Arkaqius/SmartSwitch/_00_ECAD&MCAD/_00_ECAD/SmartSwitch2.png

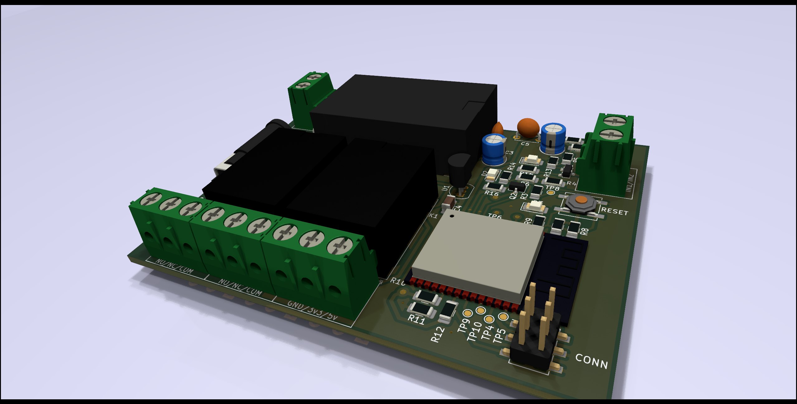
_00_ECAD&MCAD/_00_ECAD/SmartSwitch2.png
