Arkaqius/SmartSwitch/_00_ECAD&MCAD/_00_ECAD/SmartSwitch.png

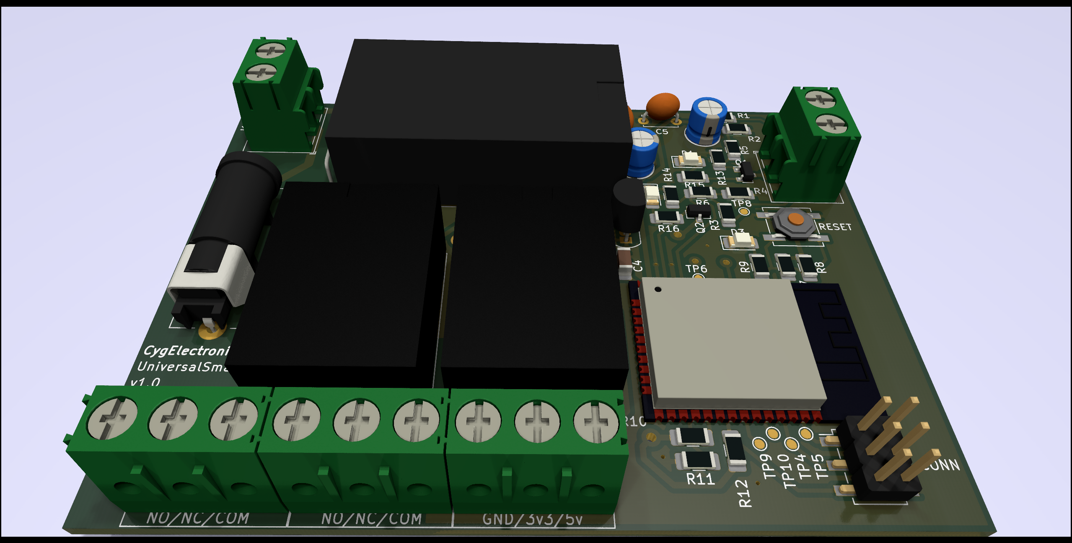
_00_ECAD&MCAD/_00_ECAD/SmartSwitch.png
