Arkaqius/SmartSwitch/_00_ECAD&MCAD/_01_MCAD/smart_switch.FCStd

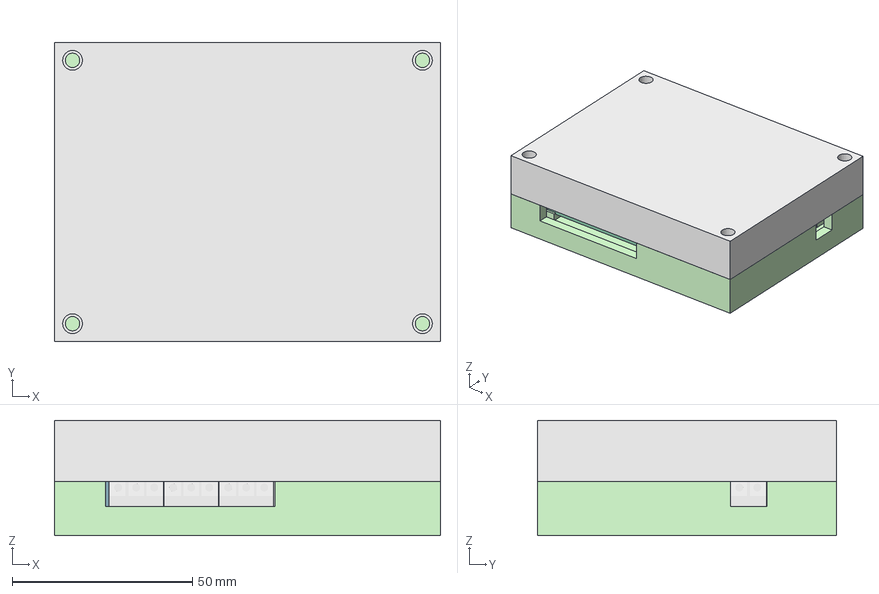
[picture p3: CAD file, 2022-10-03]
_00_ECAD&MCAD/_01_MCAD/smart_switch.FCStd
107.0 x 83.0 x 32.0 mm
Pcb_1aa9
U2_ESP32-WROOM-32_00006151aafd
R22_R_1206_3216Metric_00006151ab81
R16_R_1206_3216Metric_00006151abb1
R21_R_1206_3216Metric_00006151ac20
R13_R_1206_3216Metric_00006151ac80
R15_R_1206_3216Metric_00006151acb0
R11_R_1206_3216Metric_00006151ad40
R10_R_1206_3216Metric_00006151ada0
R14_R_1206_3216Metric_00006151add0
R12_R_1206_3216Metric_00006151ae00
R9_R_1206_3216Metric_00006151ae30
C6_CP_Radial_D50mm_P250mm_00006151aed3
Q1_SOT_23_00006151afed
R7_R_1206_3216Metric_00006151b061
R6_R_1206_3216Metric_00006151b0dc
R5_R_1206_3216Metric_00006151b10c
D5_LED_1206_3216Metric_00006151b13e
D3_LED_1206_3216Metric_00006151b174
C4_C_1206_3216Metric_00006151b1a8
R3_R_1206_3216Metric_00006151b1d8
R4_R_1206_3216Metric_00006151b22c
C5_C_Disc_D50mm_W25mm_P500mm_00006151b260
IN1/IN2_TerminalBlock_Phoenix_PT_15_2_50_H_1x02_P500mm_Horizontal_00006151b2b3
D4_LED_1206_3216Metric_00006151b31b
Q2_SOT_23_00006151b353
R8_R_1206_3216Metric_00006151b38b
NO/NC/COM 1_TerminalBlock_Phoenix_PT_15_3_50_H_1x03_P500mm_Horizontal_00006151b49c
C2_C_Disc_D50mm_W25mm_P500mm_00006151b52d
C3_CP_Radial_D50mm_P250mm_00006151b5ed
Var1_C_Disc_D60mm_W25mm_P500mm_00006151b705
NO/NC/COM 2_TerminalBlock_Phoenix_PT_15_3_50_H_1x03_P500mm_Horizontal_00006151b787
GND/3v3/5v_TerminalBlock_Phoenix_PT_15_3_50_H_1x03_P500mm_Horizontal_00006151b823
F2_R_Axial_DIN0204_L36mm_D16mm_P508mm_Vertical_00006151b899
D2_LED_1206_3216Metric_00006151bbb8
D7_D_DO-41_SOD81_P10.16mm_Horizontal_00006151b9d8
CONN_PinHeader_2x03_P254mm_Vertical_SMD_00006151ba44
U1_TO-92_Inline_Narrow_00006151bab5
R2_R_1206_3216Metric_00006151bb23
J1_TerminalBlock_Phoenix_PT_15_2_50_H_1x02_P500mm_Horizontal_00006151bc61
D1_LED_1206_3216Metric_00006151b996
D6_D_DO-41_SOD81_P10.16mm_Horizontal_00006151bbfa
RESET_SW_SPST_TL3342_000061ec6e21
Relay1
Relay2
HiLink
fuse
U3_SOT_223_00006151abe6
R19_R_1206_3216Metric_00006151ac50
R18_R_1206_3216Metric_00006151ace0
R17_R_1206_3216Metric_00006151ad10
R20_R_1206_3216Metric_00006151ad70
Q3_SOT_23_00006151b029
Q4_SOT_23_00006151b95c
R1_R_1206_3216Metric_00006151b8c5
bottom_final
bottom_final (Meshed)
top (Meshed)
