Arkaqius/SmartSwitch/_00_ECAD&MCAD/_00_ECAD/SmartSwitch.kicad_pcb

## KiCad design _00_ECAD&MCAD/_00_ECAD/SmartSwitch.kicad_pcb (2022-10-04)

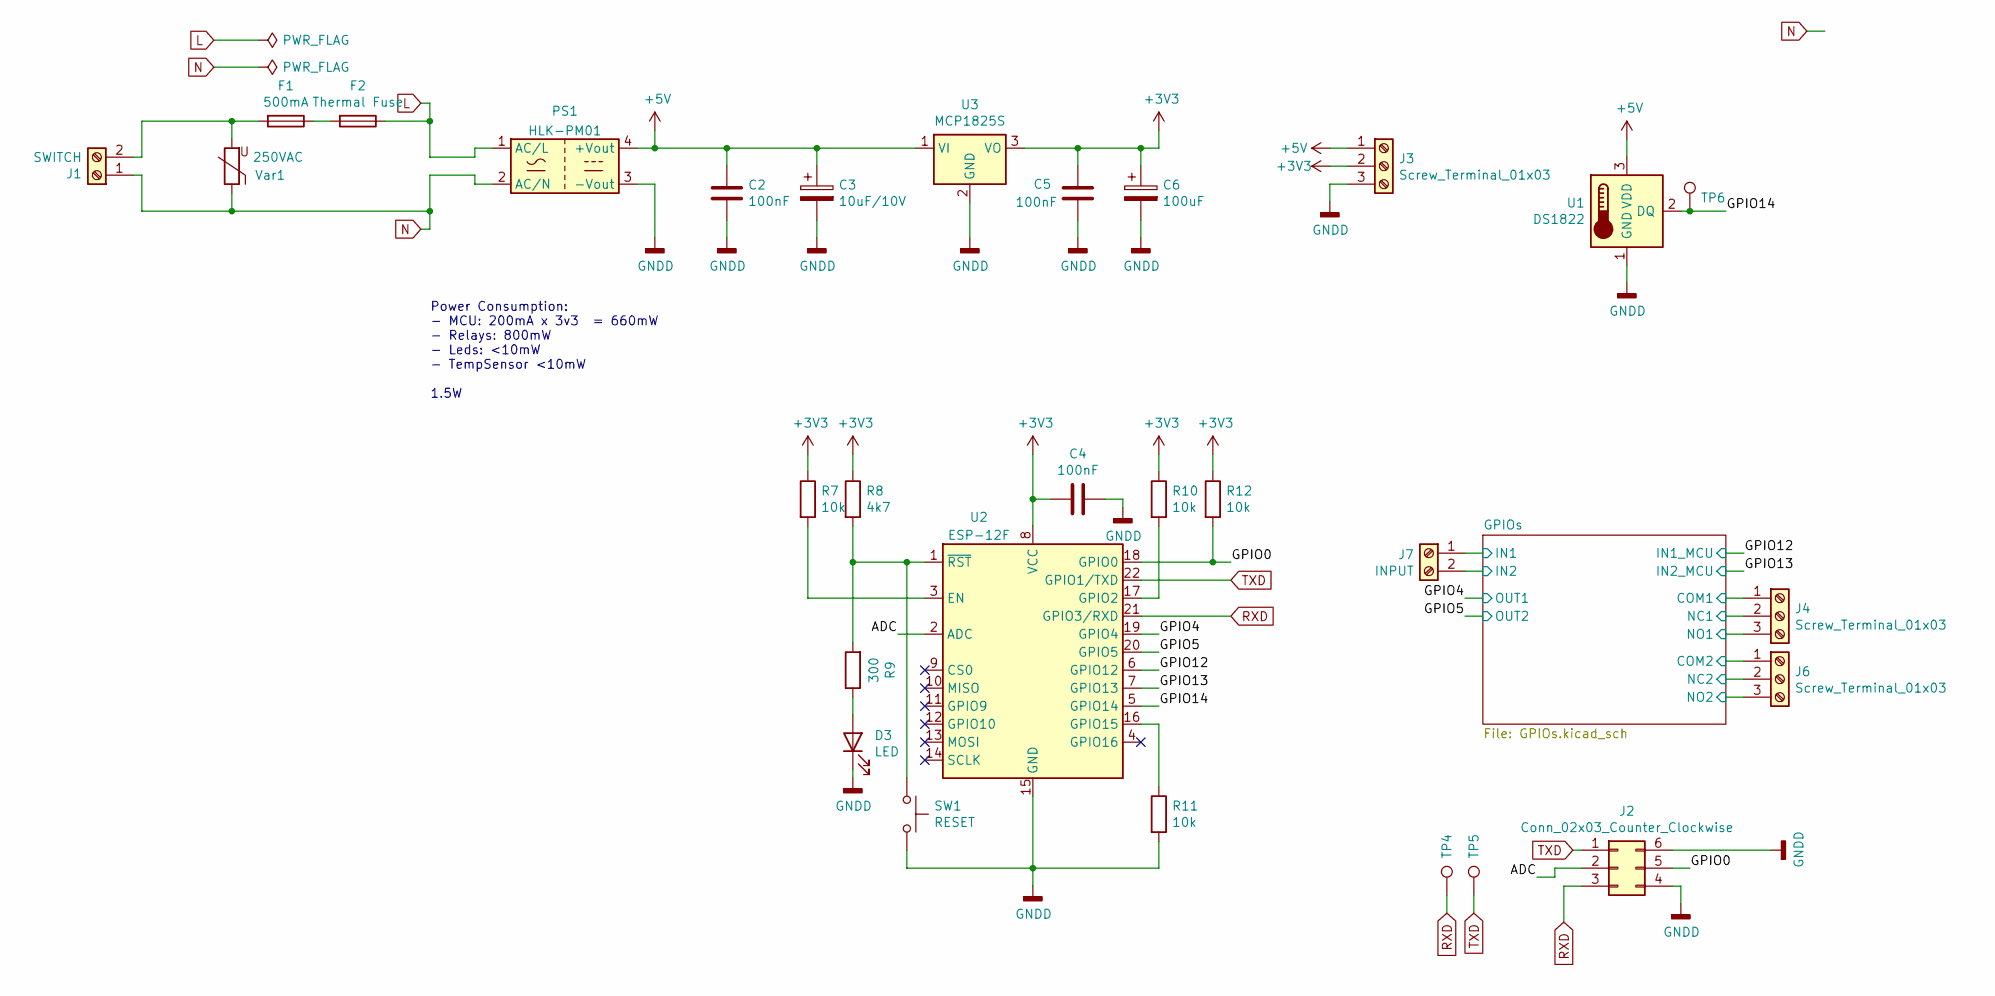
[picture p4: schematic SmartSwitch.kicad_sch]

Parts:
C2, C5: 100nF; C_Disc_D5.0mm_W2.5mm_P5.00mm
C3: 10uF/10V; CP_Radial_D5.0mm_P2.50mm
C4: 100nF; C_1206_3216Metric_Pad1.42x1.75mm_HandSolder
C6: 100uF; CP_Radial_D5.0mm_P2.50mm
D3: LED; LED_1206_3216Metric_Pad1.42x1.75mm_HandSolder
F1: 500mA; Fuseholder_Cylinder-5x20mm_Schurter_0031_8201_Horizontal_Op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
F2: Thermal Fuse; R_Axial_DIN0204_L3.6mm_D1.6mm_P5.08mm_Vertical
J1: SWITCH; TerminalBlock_Phoenix_MKDS-1,5-2_1x02_P5.00mm_Horizontal
J2: Conn_02x03_Counter_Clockwise; PinHeader_2x03_P2.54mm_Vertical_SMD
J3, J4, J6: Screw_Terminal_01x03; TerminalBlock_Phoenix_MKDS-1,5-3_1x03_P5.00mm_Horizontal
J7: INPUT; TerminalBlock_Phoenix_MKDS-1,5-2_1x02_P5.00mm_Horizontal
PS1: HLK-PM01; Converter_ACDC_HiLink_HLK-PMxx
R7, R10, R11, R12: 10k; R_1206_3216Metric_Pad1.42x1.75mm_HandSolder
R8: 4k7; R_1206_3216Metric_Pad1.42x1.75mm_HandSolder
R9: 300; R_1206_3216Metric_Pad1.42x1.75mm_HandSolder
SW1: RESET; SW_SPST_B3SL-1022P
TP4, TP5, TP6: TestPoint; TestPoint_Pad_D1.0mm
U1: DS1822; TO-92_Inline
U2: ESP-12F; ESP-12E
U3: MCP1825S; SOT-223
Var1: 250VAC; RV_Disc_D7mm_W3.4mm_P5mm

Connections:
+3V3: C4.2, C5.1, C6.1, J3.2, R7.1, R8.1, R10.1, R12.1, U2.8 (VCC), U3.3 (VO); also elsewhere on the board
+5V: C2.1, C3.1, J3.1, PS1.4 (+Vout), U1.3 (VDD), U3.1 (VI); also elsewhere on the board
/ADC: J2.2, U2.2 (ADC)
/GPIO0: J2.5, R12.2, U2.18 (GPIO0)
/GPIO4: U2.19 (GPIO4); also elsewhere on the board
/GPIO5: U2.20 (GPIO5); also elsewhere on the board
/GPIO12: U2.6 (GPIO12); also elsewhere on the board
/GPIO13: U2.7 (GPIO13); also elsewhere on the board
/GPIO14: TP6.1, U1.2 (DQ), U2.5 (GPIO14)
/GPIOs/COM1: J4.1; also elsewhere on the board
/GPIOs/COM2: J6.1; also elsewhere on the board
/GPIOs/IN1: J7.1; also elsewhere on the board
/GPIOs/IN2: J7.2; also elsewhere on the board
/GPIOs/NC1: J4.2; also elsewhere on the board
/GPIOs/NC2: J6.2; also elsewhere on the board
/GPIOs/NO1: J4.3; also elsewhere on the board
/GPIOs/NO2: J6.3; also elsewhere on the board
GNDD: C2.2, C3.2, C4.1, C5.2, C6.2, D3.1 (K), J2.4, J2.6, J3.3, PS1.3 (-Vout), R11.2, SW1.2, U1.1 (GND), U2.15 (GND), U3.2 (GND); also elsewhere on the board
L: F2.1, PS1.1 (AC/L)
N: J1.1, PS1.2 (AC/N), Var1.1
unnamed: D3.2 (A), R9.1
unnamed: F1.1, F2.2
unnamed: F1.2, J1.2, Var1.2
unnamed: R7.2, U2.3 (EN)
unnamed: R8.2, R9.2, SW1.1, U2.1 (~RST)
unnamed: R10.2, U2.17 (GPIO2)
unnamed: R11.1, U2.16 (GPIO15)
RXD: J2.3, TP4.1, U2.21 (GPIO3/RXD)
TXD: J2.1, TP5.1, U2.22 (GPIO1/TXD)

Notes on the sheet:
Power Consumption: - MCU: 200mA x 3v3 = 660mW - Relays: 800mW - Leds: <10mW - TempSensor <10mW ~{} 1.5W

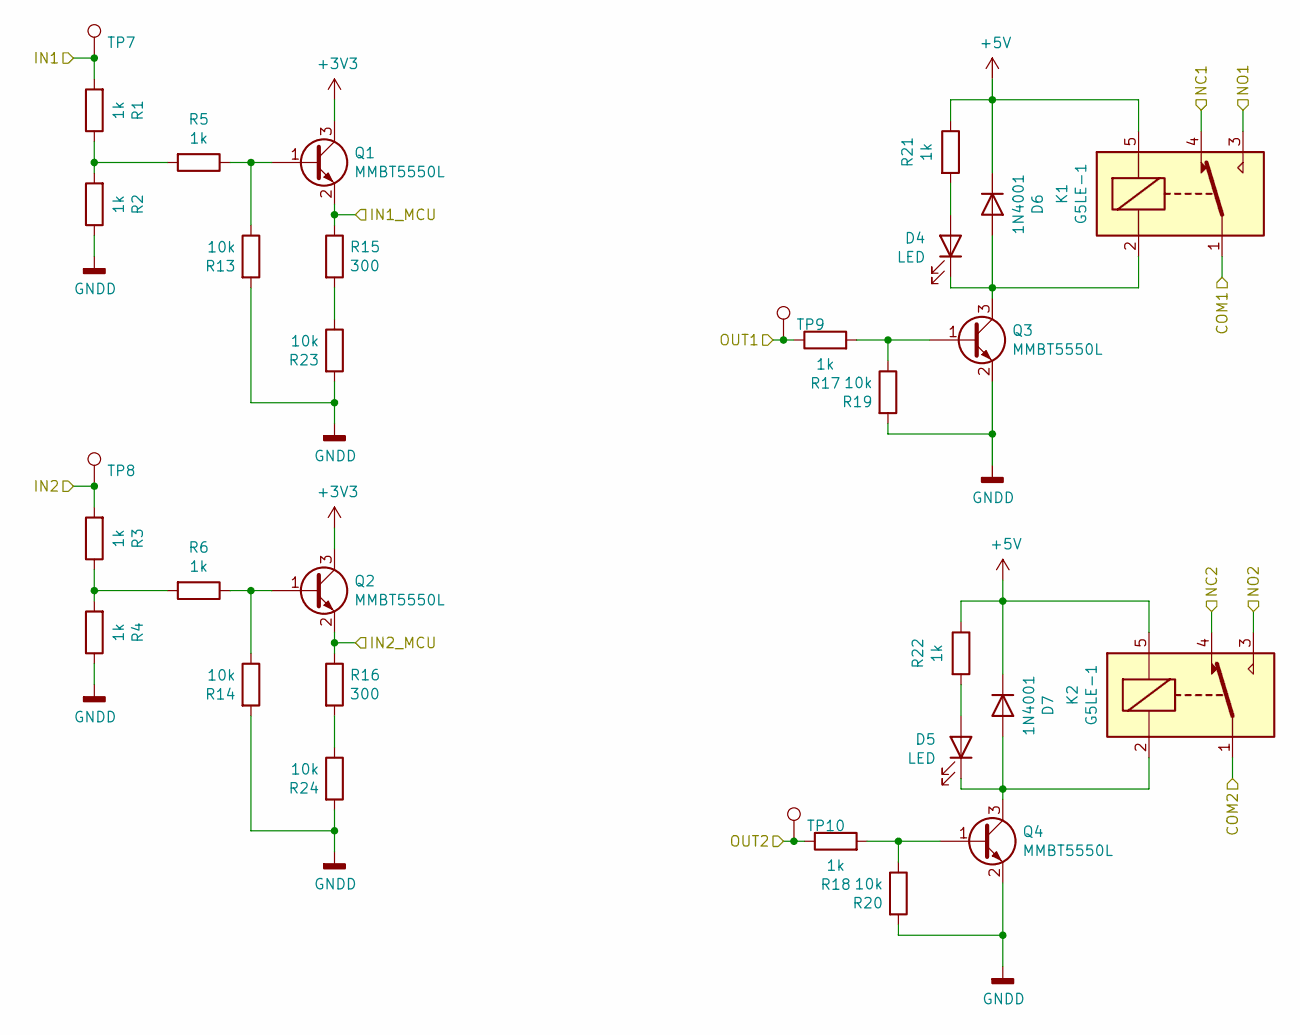
[picture p5: schematic GPIOs.kicad_sch]

Parts:
D4, D5: LED; LED_1206_3216Metric_Pad1.42x1.75mm_HandSolder
D6, D7: 1N4001; D_DO-41_SOD81_P10.16mm_Horizontal
K1, K2: G5LE-1; Relay_SPDT_Omron-G5LE-1
Q1, Q2, Q3, Q4: MMBT5550L; SOT-23
R1, R2, R3, R4, R5, R6, R17, R18, R21, R22: 1k; R_1206_3216Metric_Pad1.42x1.75mm_HandSolder
R13, R14, R19, R20: 10k; R_1206_3216Metric_Pad1.42x1.75mm_HandSolder
R15, R16: 300; R_1206_3216Metric_Pad1.42x1.75mm_HandSolder
R23, R24: 10k; R_1206_3216Metric_Pad1.30x1.75mm_HandSolder
TP7, TP8, TP9, TP10: TestPoint; TestPoint_Pad_D1.0mm

Connections:
+3V3: Q1.3 (C), Q2.3 (C); also elsewhere on the board
+5V: D6.1 (K), D7.1 (K), K1.5, K2.5, R21.1, R22.1; also elsewhere on the board
/GPIO4: R17.1, TP9.1; also elsewhere on the board
/GPIO5: R18.1, TP10.1; also elsewhere on the board
/GPIO12: Q1.2 (E), R15.1; also elsewhere on the board
/GPIO13: Q2.2 (E), R16.1; also elsewhere on the board
/GPIOs/COM1: K1.1; also elsewhere on the board
/GPIOs/COM2: K2.1; also elsewhere on the board
/GPIOs/IN1: R1.2, TP7.1; also elsewhere on the board
/GPIOs/IN2: R3.2, TP8.1; also elsewhere on the board
/GPIOs/NC1: K1.4; also elsewhere on the board
/GPIOs/NC2: K2.4; also elsewhere on the board
/GPIOs/NO1: K1.3; also elsewhere on the board
/GPIOs/NO2: K2.3; also elsewhere on the board
GNDD: Q3.2 (E), Q4.2 (E), R2.1, R4.1, R13.2, R14.2, R19.2, R20.2, R23.2, R24.2; also elsewhere on the board
unnamed: D4.1 (K), D6.2 (A), K1.2, Q3.3 (C)
unnamed: D4.2 (A), R21.2
unnamed: D5.1 (K), D7.2 (A), K2.2, Q4.3 (C)
unnamed: D5.2 (A), R22.2
unnamed: Q1.1 (B), R5.1, R13.1
unnamed: Q2.1 (B), R6.1, R14.1
unnamed: Q3.1 (B), R17.2, R19.1
unnamed: Q4.1 (B), R18.2, R20.1
unnamed: R1.1, R2.2, R5.2
unnamed: R3.1, R4.2, R6.2
unnamed: R15.2, R23.1
unnamed: R16.2, R24.1

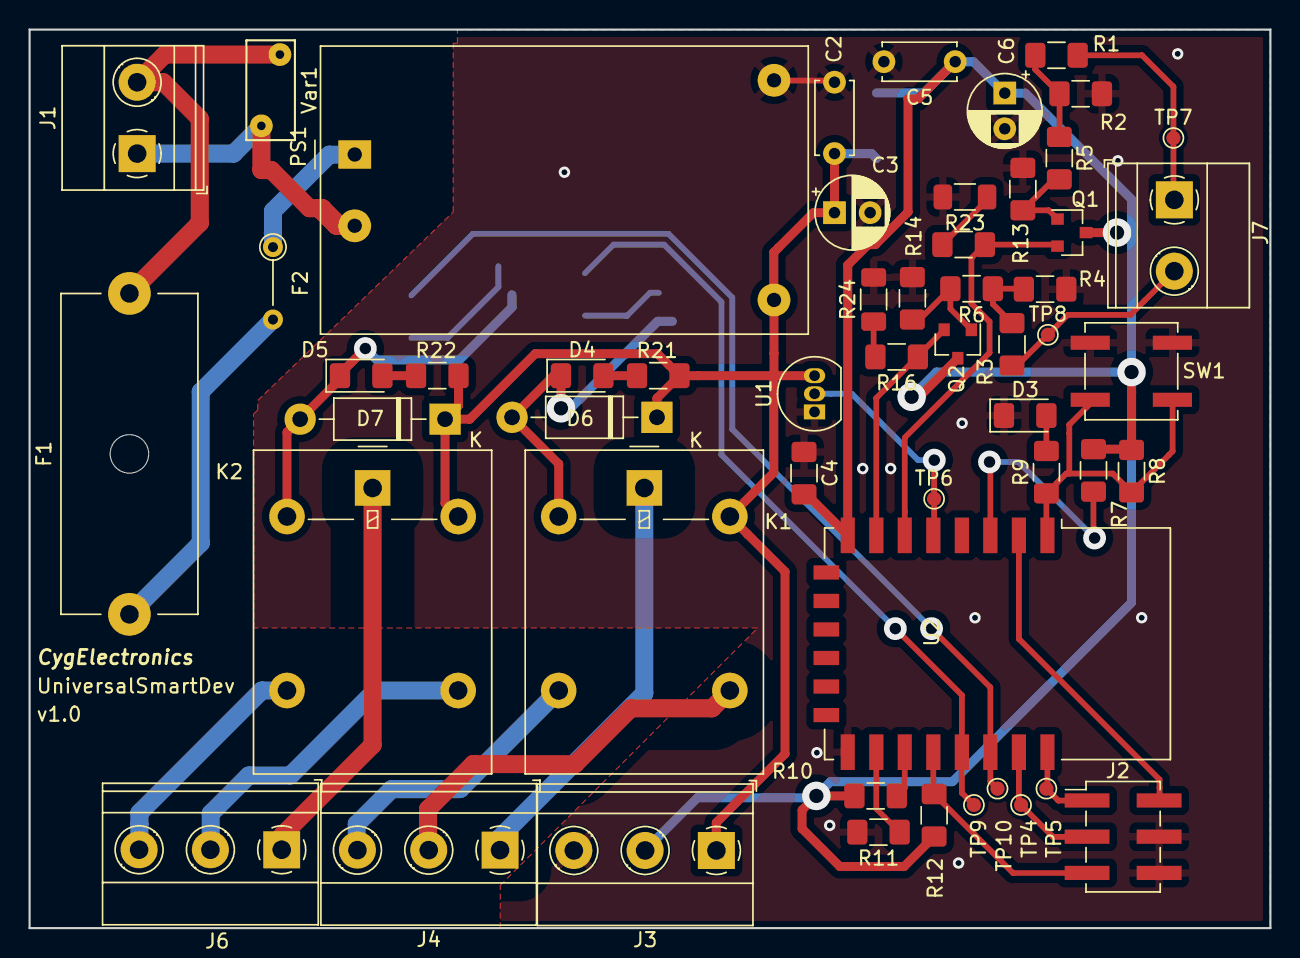
[picture p6: board SmartSwitch.kicad_pcb from above]

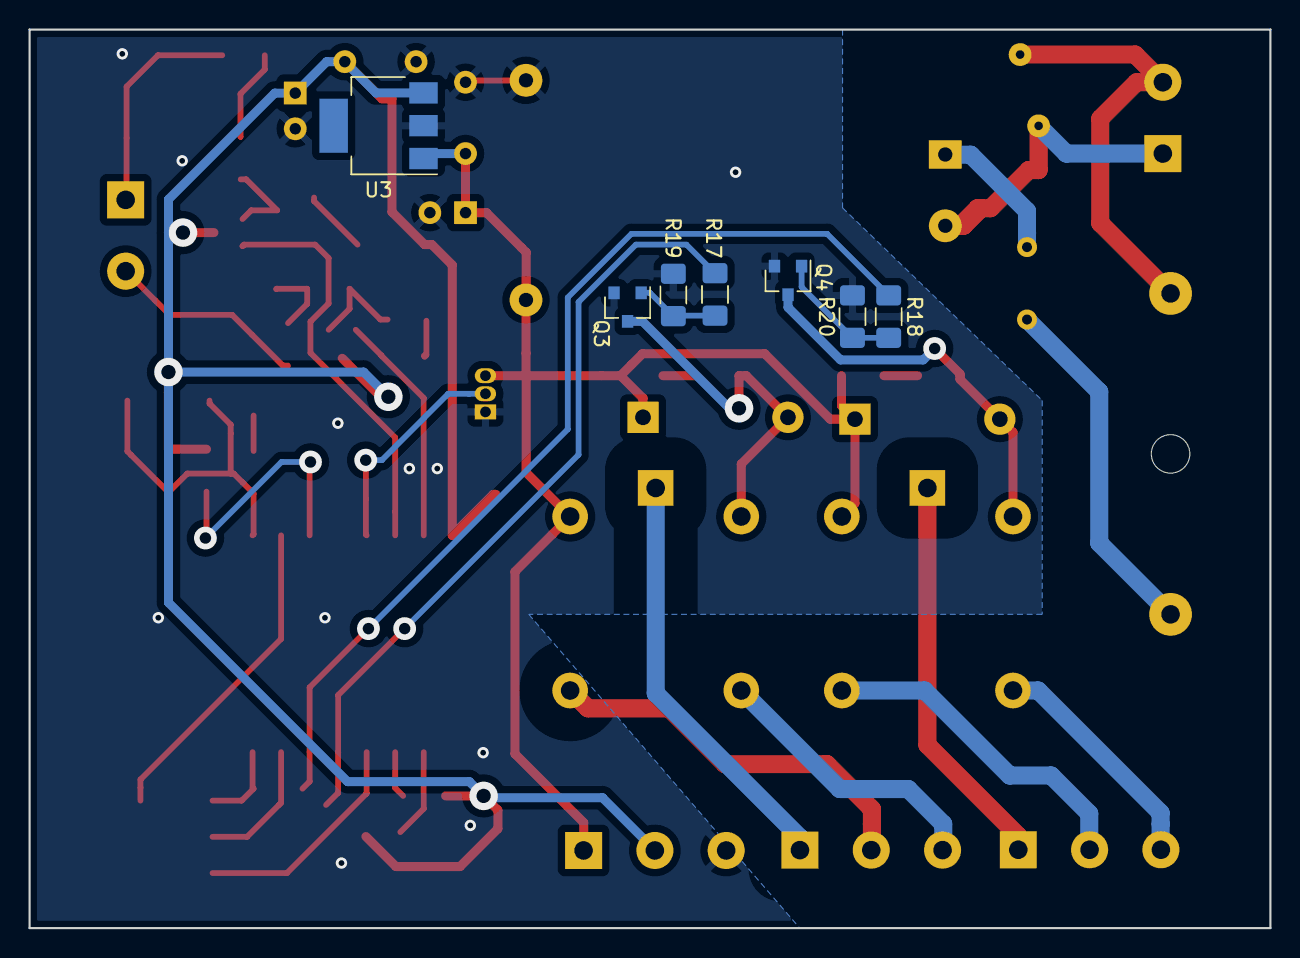
[picture p7: board SmartSwitch.kicad_pcb from below]

Board: 2 copper layers, 87.0 x 63.0 mm, 61 parts (7 on the bottom side), 41 nets.
