Arkaqius/SmartSwitch/_01_SW/modules/drivers/include/ds18b20.h

#ifndef __DS18B20_H__
#define __DS18B20_H__

#include "ets_sys.h"
#include "osapi.h"
#include "gpio.h"

#define DS18B20_MUX		PERIPHS_IO_MUX_MTMS_U
#define DS18B20_FUNC	FUNC_GPIO14
#define DS18B20_PIN		14

#define DS1820_WRITE_SCRATCHPAD		0x4E
#define DS1820_READ_SCRATCHPAD		0xBE
#define DS1820_COPY_SCRATCHPAD 		0x48
#define DS1820_READ_EEPROM 		0xB8
#define DS1820_READ_PWRSUPPLY 		0xB4
#define DS1820_SEARCHROM 		0xF0
#define DS1820_SKIP_ROM			0xCC
#define DS1820_READROM 			0x33
#define DS1820_MATCHROM 		0x55
#define DS1820_ALARMSEARCH 		0xEC
#define DS1820_CONVERT_T		0x44

static uint16_t oddparity[16] = {0, 1, 1, 0, 1, 0, 0, 1, 1, 0, 0, 1, 0, 1, 1, 0};

void ds_init();
int ds_search(uint8_t *addr);
void ds_select(const uint8_t rom[8]);
void ds_skip();
void ds_reset_search();
uint8_t ds_reset(void);
void ds_write(uint8_t v, int power);
void ds_write_bit(int v);
uint8_t ds_read();
int ds_read_bit(void);
uint8_t ds_crc8(const uint8_t *addr, uint8_t len);
uint16_t ds_crc16(const uint16_t *data, const uint16_t  len);

#endif
