Arkaqius/SmartSwitch/_01_SW/modules/include/common.h

/*
 * common.h
 *
 *  Created on: 24.02.2022
 *      Author: kulet
 */

#ifndef CORE_INCLUDE_COMMON_H_
#define CORE_INCLUDE_COMMON_H_


typedef enum func_result {ERROR = 0, SUCESS =1} func_result;



#endif /* CORE_INCLUDE_COMMON_H_ */
