Arkaqius/SmartSwitch/(commit log)

2022-10-03 First release
    [5v0To3v3.sch, GPIOs.kicad_sch, GPIOs.sch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]
2022-10-04 Fix LED, common emitter issue, add adc feature
    [GPIOs.kicad_sch, SmartSwitch.kicad_pcb, SmartSwitch.kicad_sch]
